BotyB/Automatic-Plant-Watering-System/README.md

# Automatic Plant Watering System

This project is an automatic watering system designed to care for up to four plants independently.

Each plant has its own capacitive soil-moisture sensor and dedicated water pump. Instead of watering every plant on a fixed schedule, the system checks the condition of each pot and waters only the plant whose soil has become too dry.

The system is controlled by an ESP32 microcontroller and uses a four-channel relay module to operate the pumps. Two water-level protection systems monitor the reservoir and prevent the pumps from running when there is not enough water available.

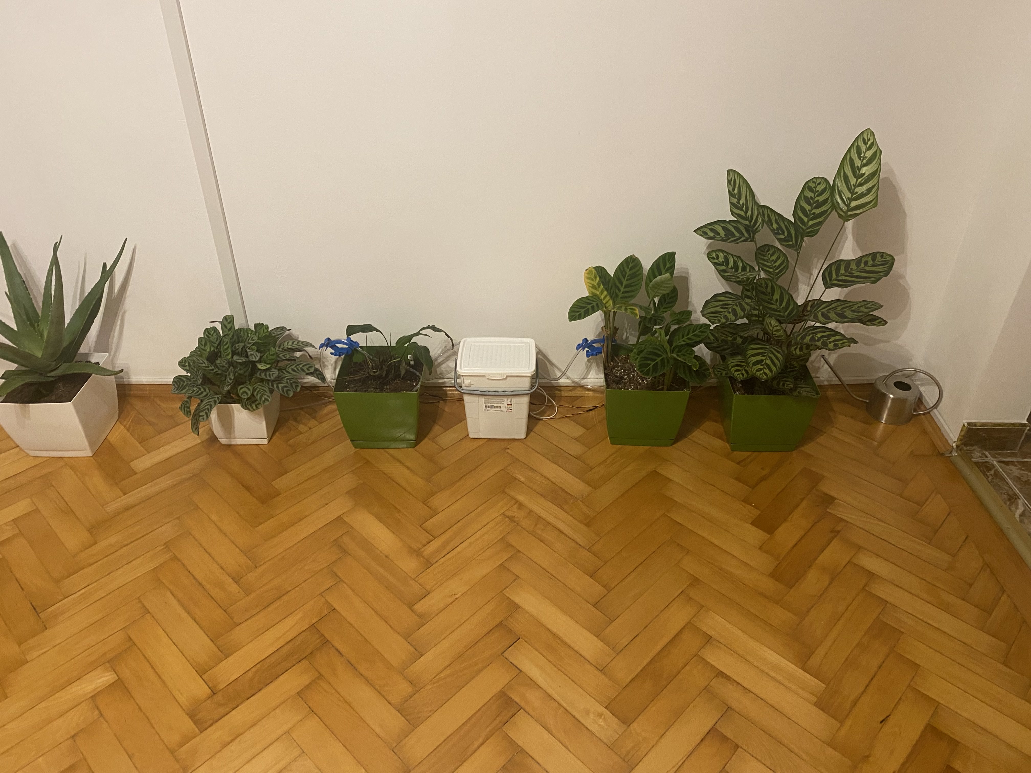
[picture p1: IMG_1337.jpg]


*First Water Bucket that was later replaced with a shorter one*

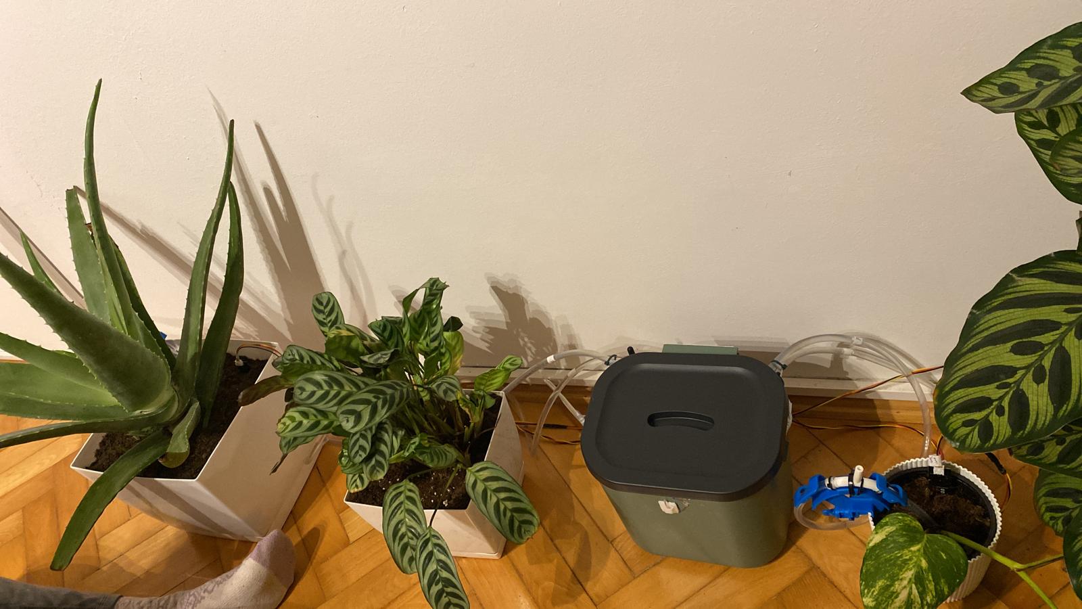
[picture p2: IMG_1446.jpg]


*Final Water Bucket that has a shorter and more compact design*

The main goal was to create a practical system that reduces manual plant care while avoiding both underwatering and unnecessary repeated watering.

## Main Features

* Monitors the soil moisture of four plants separately
* Uses one dedicated water pump for each plant
* Automatically waters only the plants that are too dry
* Monitors the water reservoir level
* Prevents the pumps from running dry
* Can be monitored and controlled through Blynk
* Allows moisture thresholds to be adjusted for different plants
* Uses ventilation lines to prevent unwanted water siphoning after a pump stops
* Uses one pump at a time to reduce peak current
* Includes both software and hardware water-level protection
* Provides visual warning patterns through a front status LED

The system was built as a practical home automation project and can be expanded later with additional sensors, notifications, data logging, or more watering zones.

## 1. Project Idea

The original idea was to build one controller capable of caring for four separate plants.

Each plant would have:

* One soil-moisture sensor
* One dedicated water pump
* One separate water hose
* Its own moisture threshold
* Its own watering interval

This allows plants with different water requirements to be monitored independently instead of treating all four pots as one watering zone.

## 2. Initial Planning

The project began with a paper sketch showing the complete electrical layout before any permanent wiring was made.

The design used one main 5V power source divided into two functional branches.

Original Paper Wiring Sketch


### Logic Branch

The logic branch supplies the low-current electronics:

* ESP32 microcontroller
* Four capacitive soil-moisture sensors
* Four-channel relay control circuit
* Front status LED
* Water-level status input

The four soil sensors are powered from the ESP32's 3.3V output. Their analog signal wires are connected to GPIO pins:

* Sensor 1: GPIO 32
* Sensor 2: GPIO 33
* Sensor 3: GPIO 34
* Sensor 4: GPIO 35

These pins belong to ADC1, which means they can still be used while the ESP32 Wi-Fi connection is active.

The four relay-control inputs are connected to:

* Relay 1: GPIO 16
* Relay 2: GPIO 17
* Relay 3: GPIO 18
* Relay 4: GPIO 19

The warning LED is connected to GPIO 25 through a current-limiting resistor of approximately 220–330 ohms.

### Pump-Power Branch

The second branch supplies the higher-current side of the system:

* Four 5V water pumps
* Relay common terminals
* Hardware water-level cutoff
* Main pump-power path

Separating the logical control section from the higher-current pump branch made the system easier to understand and reduced the chance of pump current affecting the ESP32.

Both branches still share the same 5V supply and common ground. They are functionally separated, not electrically isolated.

## 3. Component Selection

The first stage involved choosing the sensors, pumps, relay module and operating voltage.

Capacitive soil-moisture sensors were selected instead of exposed-metal resistive probes. Capacitive sensors are generally more suitable for long-term installation because the sensing surface does not rely on two exposed metal electrodes that gradually corrode in wet soil.

A four-channel relay module was selected because it allows the ESP32 to switch each pump independently while keeping pump current away from the ESP32 GPIO pins.

Pumps, Sensors and Hoses


*Four capacitive soil sensors, four 5V water pumps and watering hoses.*

Four-Channel Relay


*Four channel relay*

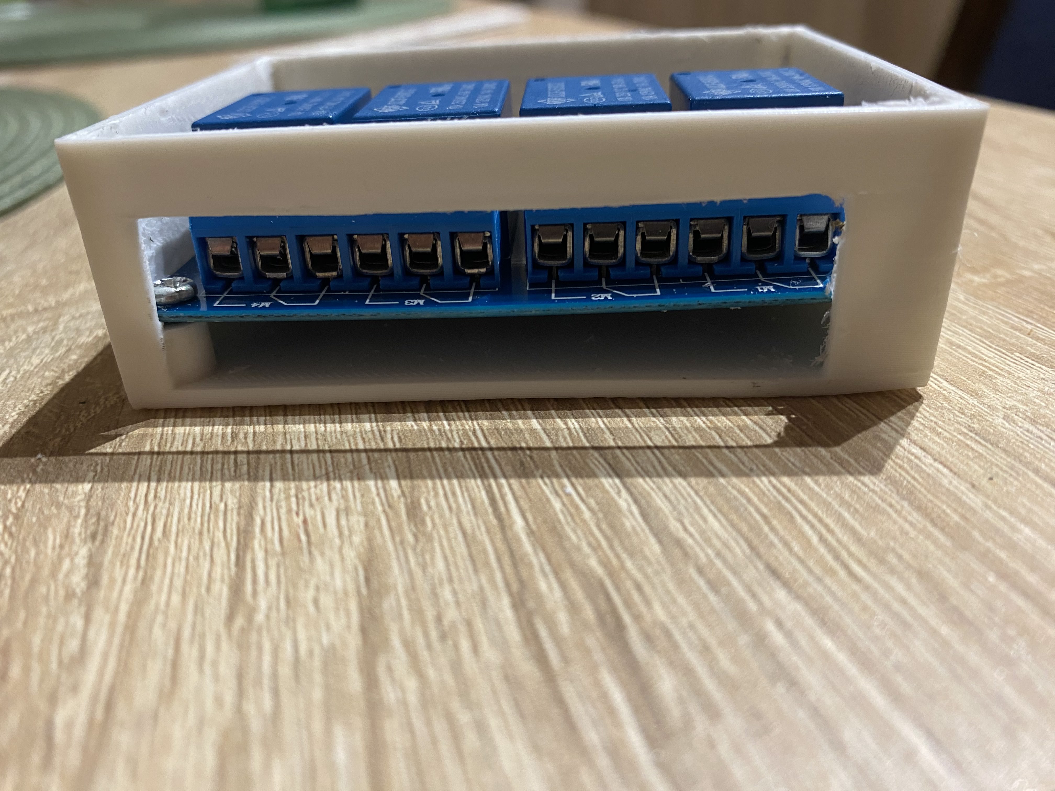
[picture p6: IMG_1287.jpg]
Four-Channel Relay With Case


*I made a custom 3D printed case for the four-channel relay module used to control the pumps independently.*

ESP32-U


*ESP32 38-pin model U with external U.fl antenna*

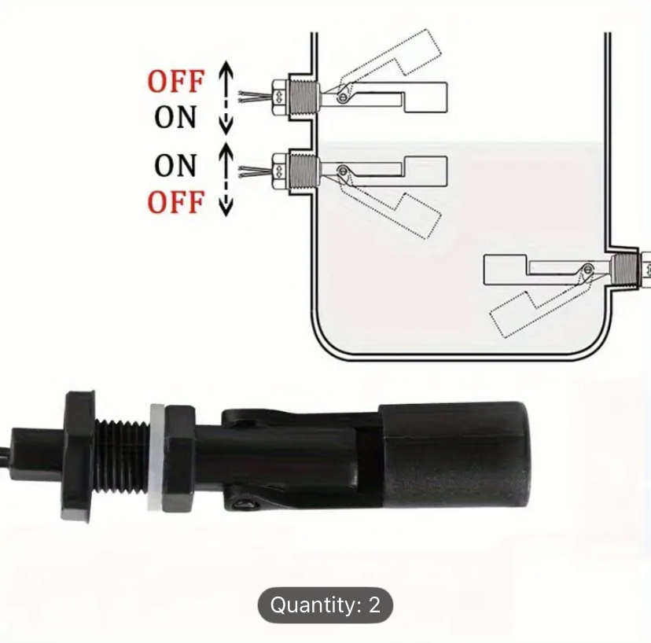
[picture p8: IMG_1284.jpg]


*Schematic of how the floating sensor works*

**NOTE: The sensor can be installed both ways with ballast hanging down or raising with water level**

Reservoir Testing

*The water level sensor that will sit inside the water bucket, its a simple switch that can be used both with the ballast lowering down or rising as water level raises*



*Here i am testing if the sensor works and to check how to install it*

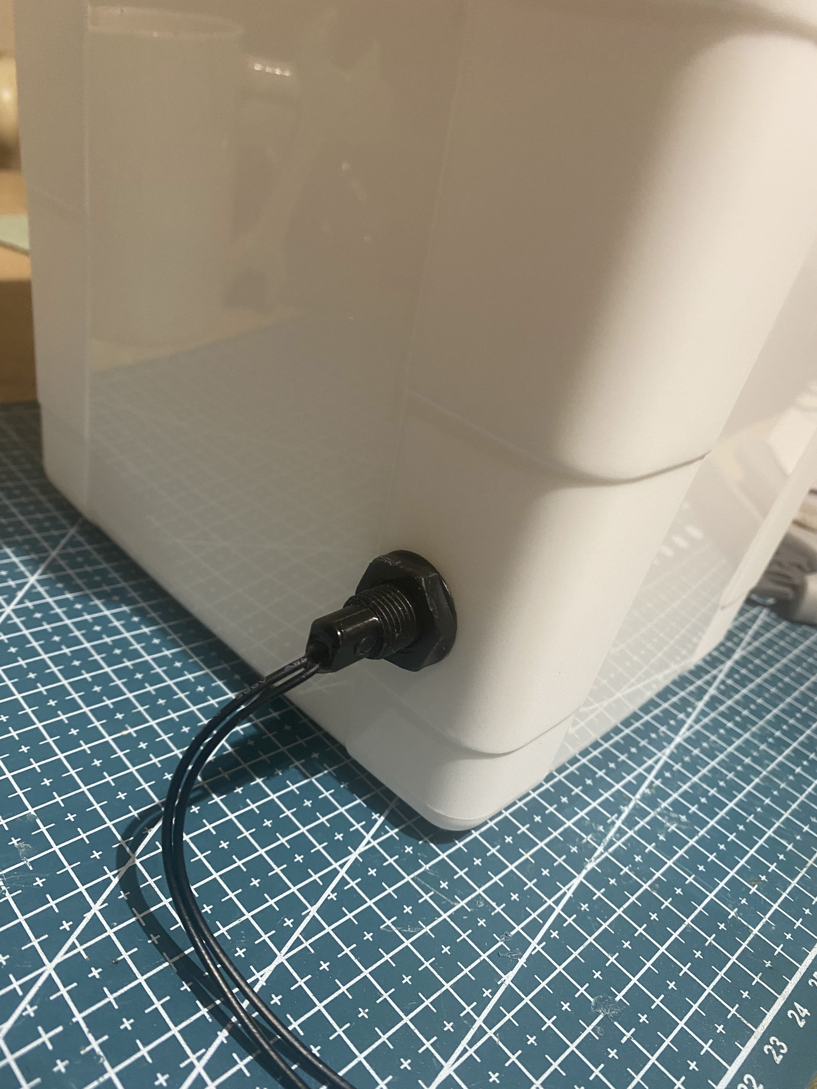
[picture p11: IMG_1316.jpg]
Modified Reservoir


*I have installed the sensor at the lowest point of the first water bucket model leaving some space from the bottom so it will not get stuck*

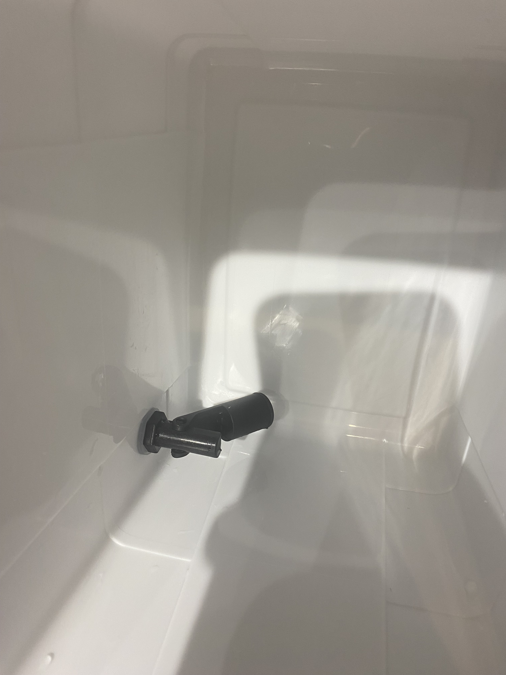
[picture p12: IMG_1317.JPG]
Reservoir Inside POV


*The interior of the bucket with one sensor installed as close to the bottom as possible*

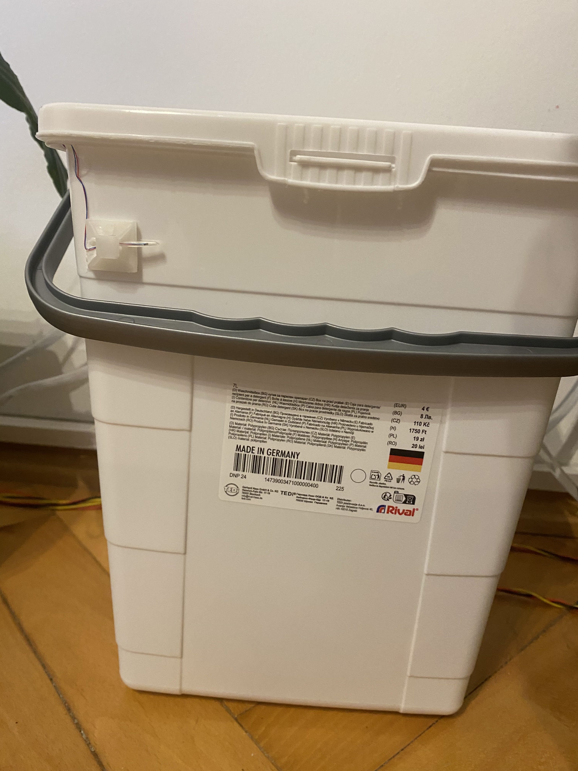
[picture p13: IMG_1350.jpg]
Original Reservoir


**The original taller water reservoir considered during the first build.**

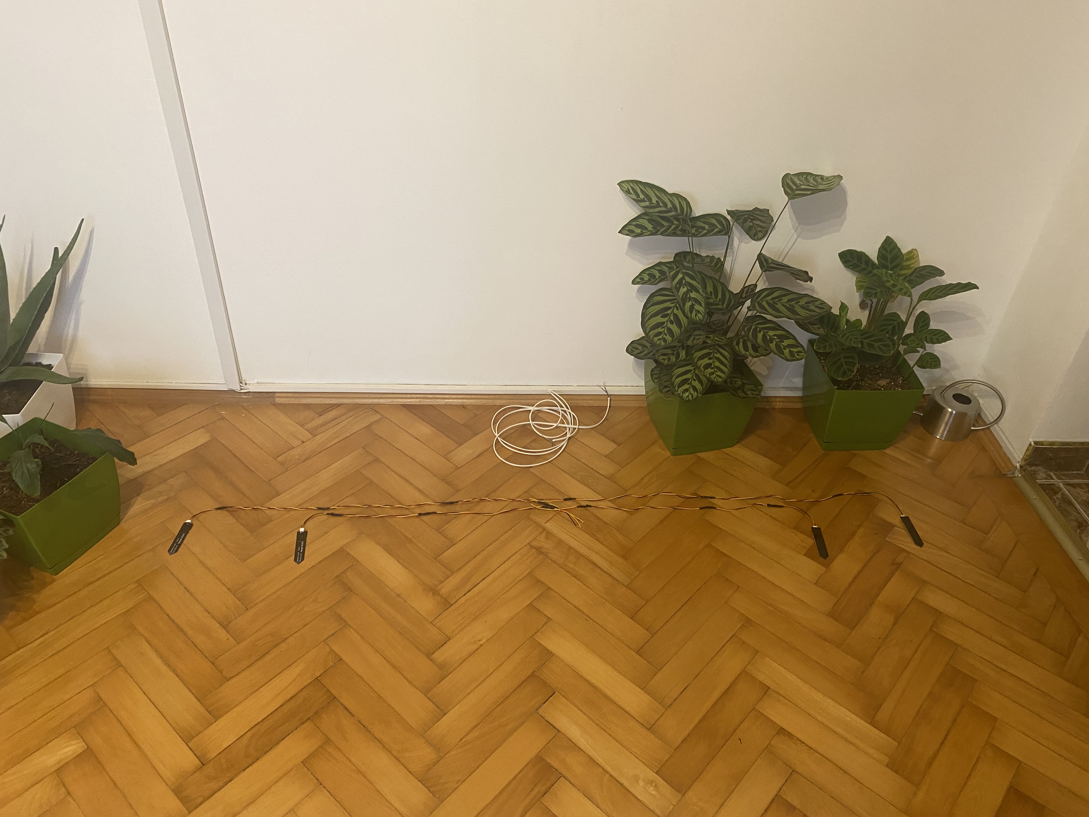
[picture p14: IMG_1331.JPG]
Measuring Sensors Reach

*Measuring how far should the sensors reach all four flower pots*

Reservoir With Sensor And Pumps Installed

*Float sensor and water pumps all installed at the bottom of the bucket, ready to be tested*

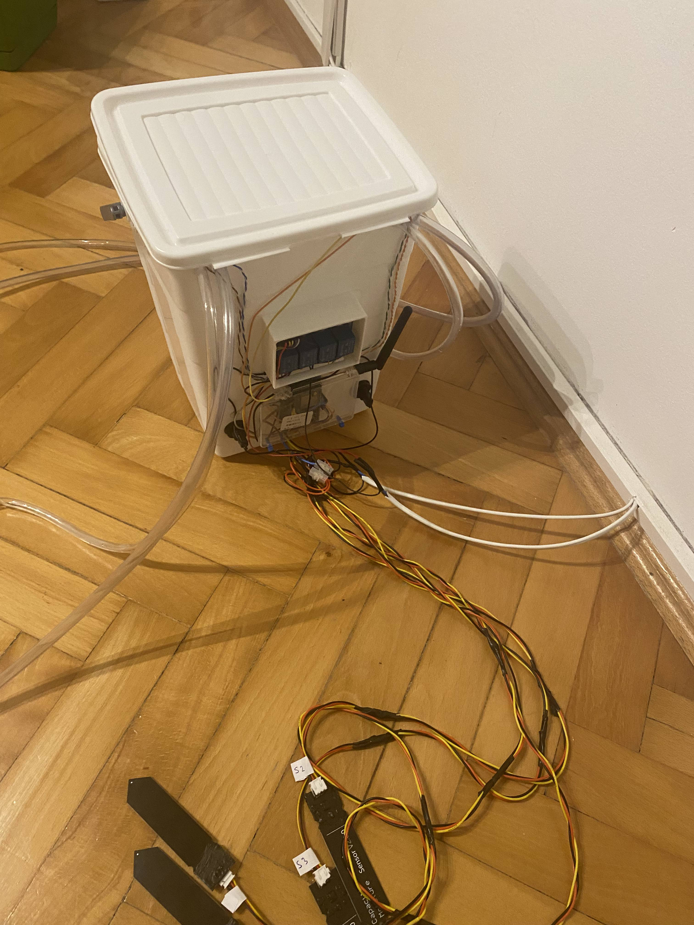
[picture p16: IMG_1335.jpg]
Original Reservoir Mounted Components

*All component are wired and glued to the bucket to be tested with a 5v wall charger rated 3 Amps* 

Both 12V and 5V pumps were considered. The final system uses 5V pumps, allowing the ESP32, relay module and pumps to operate from one suitably rated 5V wall power supply.

A power supply rated for approximately 3A was selected to provide enough current for the controller and pumps. Because the final components all operate from compatible voltages, additional buck converters were not required.

Only one pump is operated at a time. This reduces the peak load on the power supply and prevents several pumps from starting simultaneously.

## 4. Controller and Wireless Connection

The ESP32 provides:

* Built-in Wi-Fi
* Enough GPIO pins for four sensors and four relays
* Multiple ADC1 analog inputs
* Blynk compatibility
* Timers and automatic watering logic
* Remote monitoring and manual control

ESP32-U Controller

*The ESP32-U was fitted inside this plastic container in the case of water getting near it with only the bottom being exposed for code re-flashing* 

An ESP32-U development board was selected as the main controller.

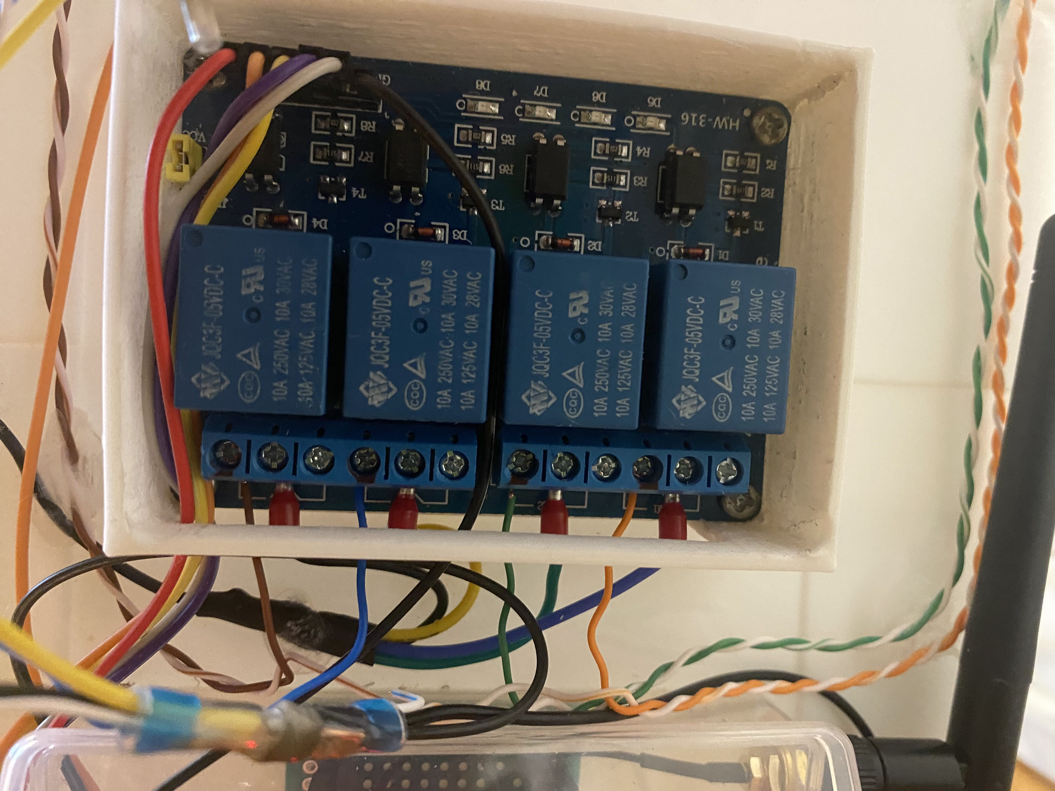
[picture p18: IMG_1340.jpg]
Original Reservoir Mounted Components Back

*The 4-channel relay on the back of the bucket*

**NOTE: it is marked as 250/125/30/28 Volt AC but it works perfectly with a 5v 3A wall charger**

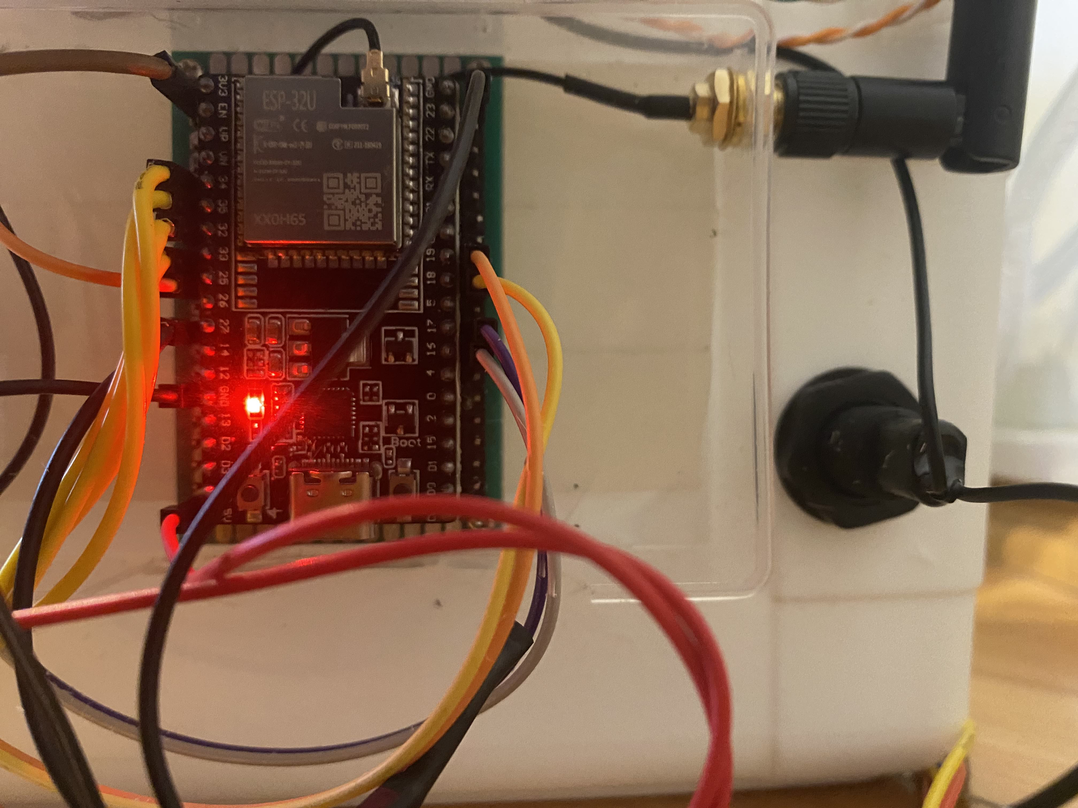
[picture p19: IMG_1341.jpg]
Original Reservoir Mounted Components Back1

*ESP32 powered up and ready to be tested*

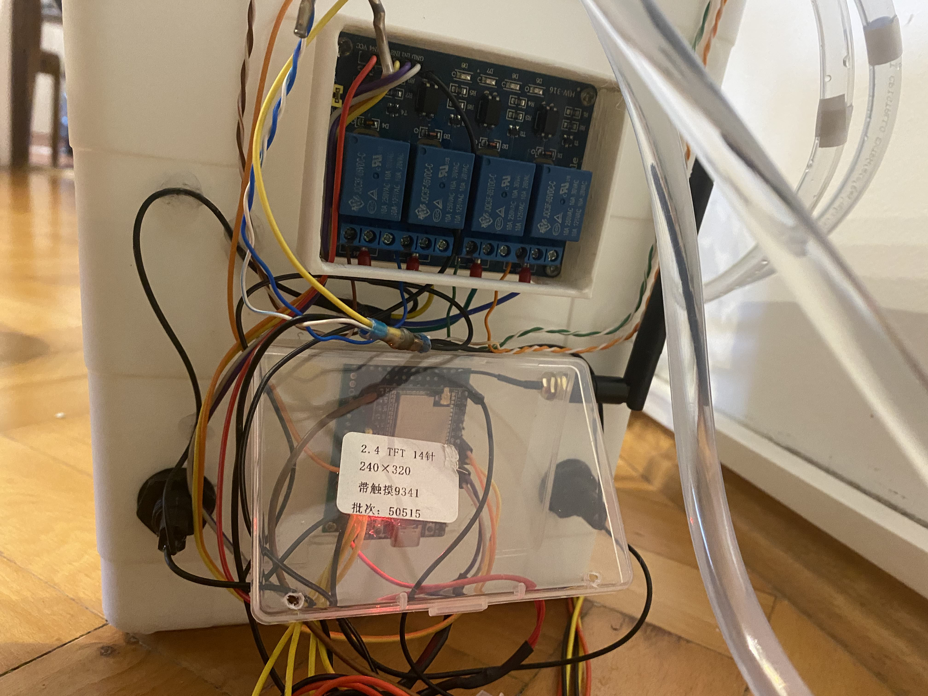
[picture p20: IMG_1342.jpg]
Original Reservoir Mounted Components Back2

*Checking if pump is arming when ESP32 is triggered*

**NOTE: Here you can also see that the system uses dual water level sensors, one is for actual level and the second one is for the main fail-safe for the pumps to shut off when there is no water**

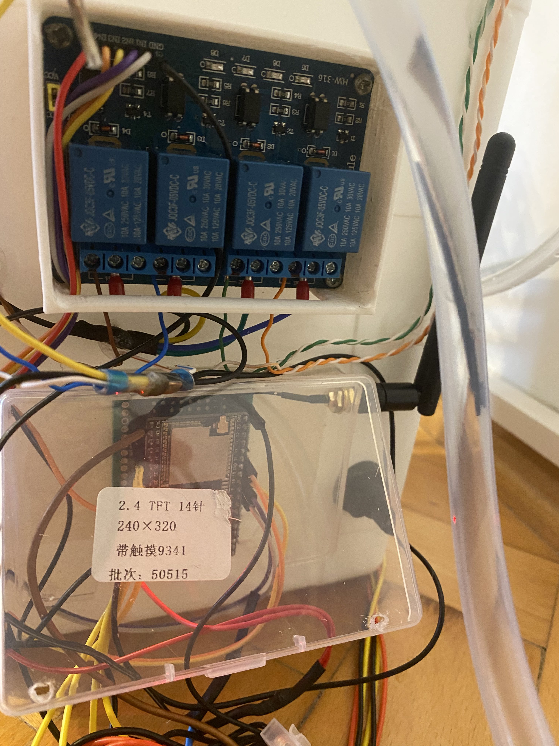
[picture p21: IMG_1343.jpg]
Original Reservoir Mounted Components Back3

*Added zip-tie holes so i can close the lid of the ESP32*

**NOTE: final design uses 2x water level sensors so one shots off the pumps from starting dry and the other to show the water level in the app**

The ESP32-U version was chosen because it supports an external antenna through a U.FL connector.

Although a regular ESP32 module with a PCB antenna may be sufficient in many indoor installations, the external antenna provides more freedom when mounting the controller inside an enclosure or near objects that can weaken the Wi-Fi signal.

The antenna can be positioned outside or away from the main electronics enclosure, improving the reliability of the connection to the router.

Some ESP32 boards that include both a PCB antenna and a U.FL connector require a small hardware antenna-selection change. This should be checked for the exact board model before connecting an external antenna.

## 5. Soil Sensor Protection

Only the lower sensing section of a capacitive soil sensor is intended to remain inside the soil.

The upper electronic section contains exposed components and solder joints that can be damaged by water, condensation or wet soil. This section was protected using liquid electrical tape or silicone sealant.

At first i was considering to use a water sensor that measures the water level but after some research and testing it proved ineffective for this project

Water Sensor mk1
First water sensor i considered to use but its main weakness is that the traces corrode quite fast so it got scrapped

After swapping, i tested the Capacitive Soil Sensor v2.0 since i have read that the older v1.3 had some issues with the reliability of the sensor.

Testing Soil Sensor Voltage

*Here the Soil Sensor is tested in water if the voltage changes with the moisture level*

Testing Soil Sensor Voltage Wet

*The voltage has dropped to 1.4v as expected*

Testing Soil Sensor Voltage Dry

*Then when in dry air the voltage raises to 2.7v. This is by design since the capacitance changes*

**NOTE: This type of sensor measures moisture and by design in dry air it will output around 3v and in wet soil it will reach around 1v**

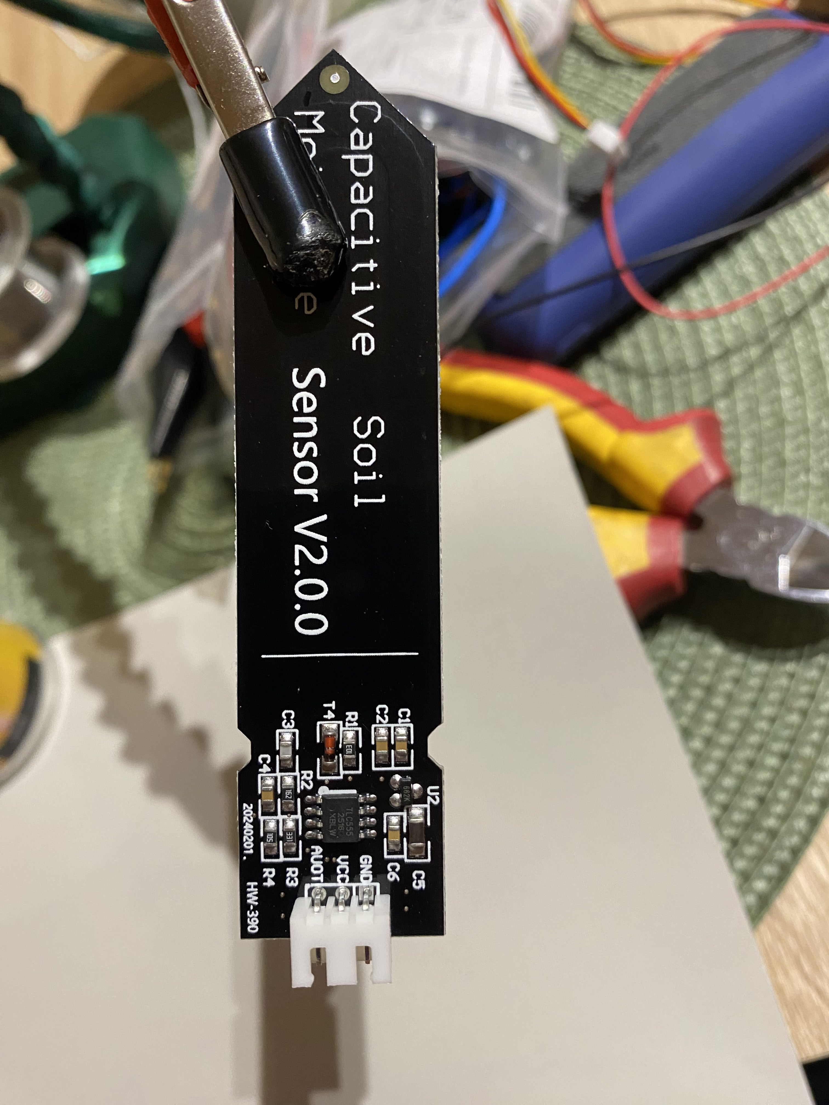
[picture p25: IMG_1112.jpg]

*This was the chosen soil sensor but this design has a major flaw, its electronics are exposed to water damage*

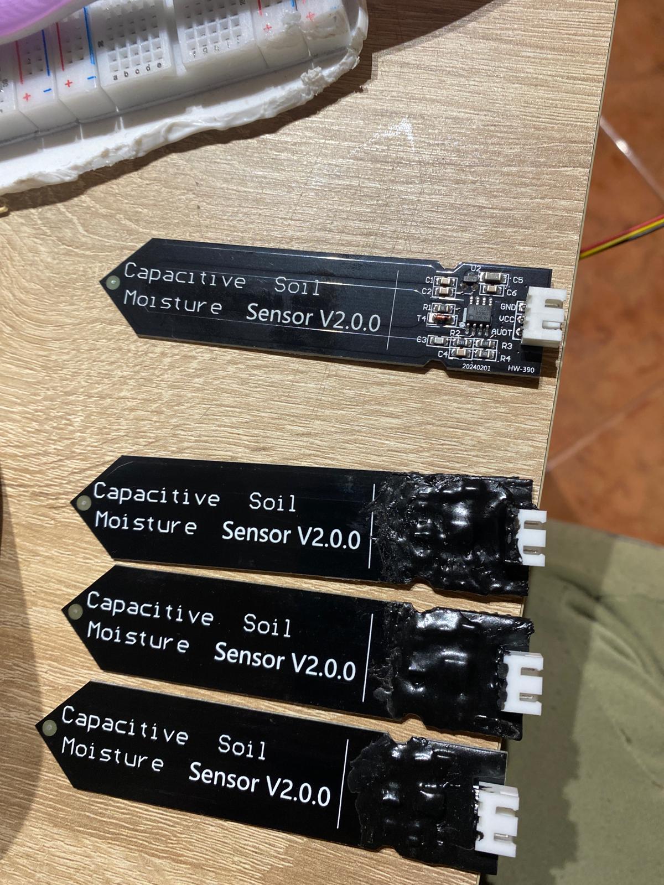
[picture p26: IMG_1443.jpg]

*The sensors have been coated with liquid tape to protect from damage* 

The protective coating was applied around:

* The electronic components
* Solder joints
* Cable connection
* Upper edge of the circuit board

The active sensing area was left uncovered so the sensor could continue measuring changes in soil moisture correctly.

Care was also taken not to bury the electronic section below the soil line.

## 6. 3D-Printed Flow Breakers and Vent Lines

To fully stop unwanted siphoning, custom 3D-printed flow breakers were added near the ends of the watering hoses.

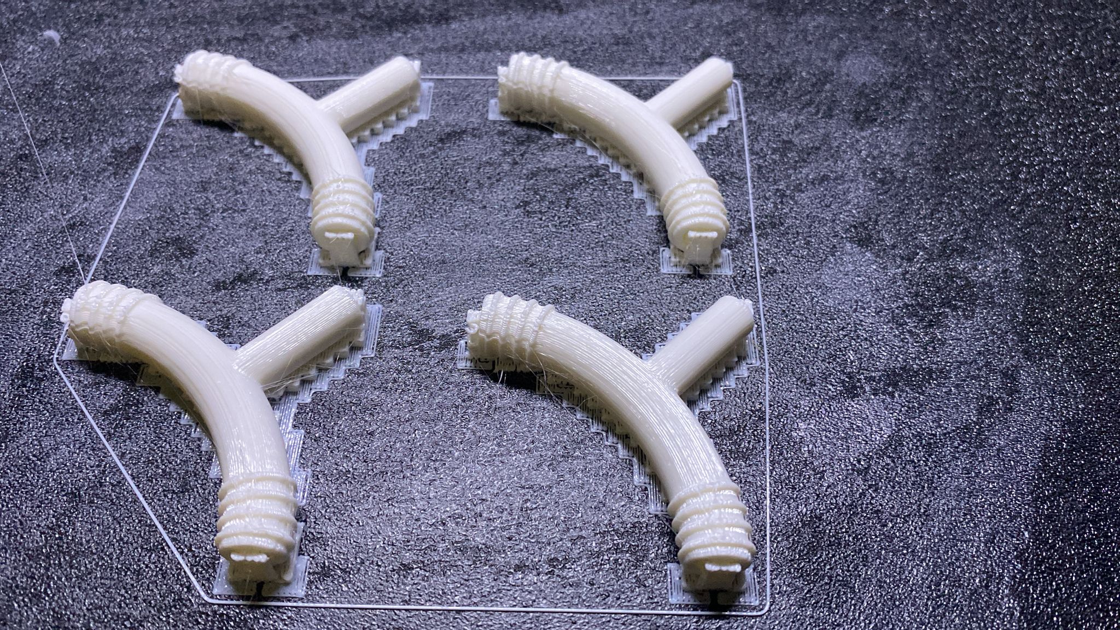
[picture p27: IMG_1431.jpg]
3D Printed Flow Breaker

*I have made this design so it will fit the chosen hoses and to break the syphon effect since it lets water get inside with the top vent*

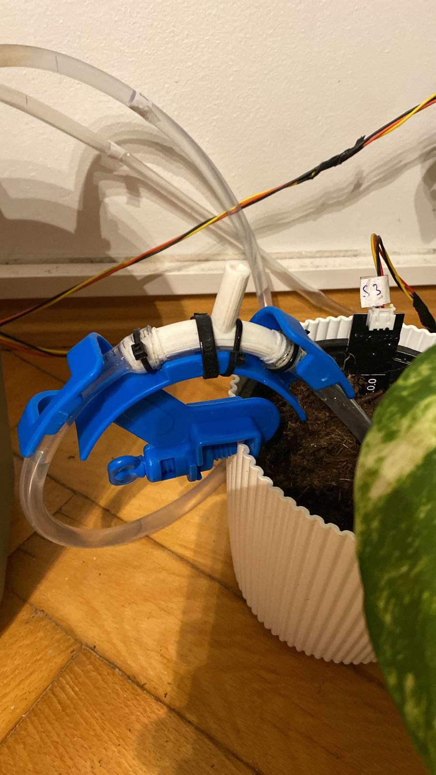
[picture p28: IMG_1444.jpg]
3D Printed Flow Breaker Plant

*Installed on the plant pot holder and with the syphon breaker added*

Each outlet includes a curved vent section that allows air to enter the hose after the pump stops. Introducing air breaks the continuous water column inside the hose and interrupts the siphon effect.

Without the vent, a hose filled completely with water can continue drawing water from the reservoir even though the pump is no longer powered.

The final arrangement provides two forms of siphon protection:

* A shorter reservoir with less height above the plants
* Vented 3D-printed hose outlets that break the water column

This ensures that each plant receives approximately the intended pump dose rather than continuing to receive water through gravity flow.

## 7. Water Reservoir and Siphon Problem

**NOTE: Please do read the whole project since in early testing the system worked but i had an unforeseen problem that the pump stopped but the water kept syphoning and it filled the pot till it got out**

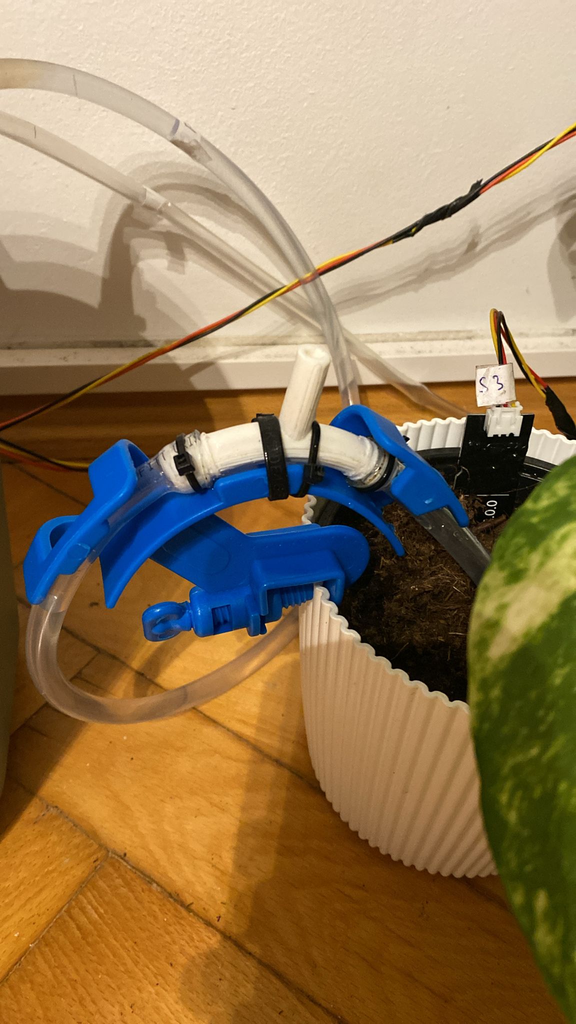
[picture p29: IMG_1432.jpg]
Front Status LED


*3D printed syphon breakers were added so air can enter and break the syphon effect*

*After more testing i have found that the vent was not tall enough*

*NOTE: The vent was tilted forward towards the flower pot so any leaking water will spill back into the pot not out*

**NOTE #2: If you do not have a 3D printer or find an adequate syphon breaker you can just poke a hole with a thicker needle in the top part of the hose to get the exact same effect, just check if the water will flow back inside the pot or out**

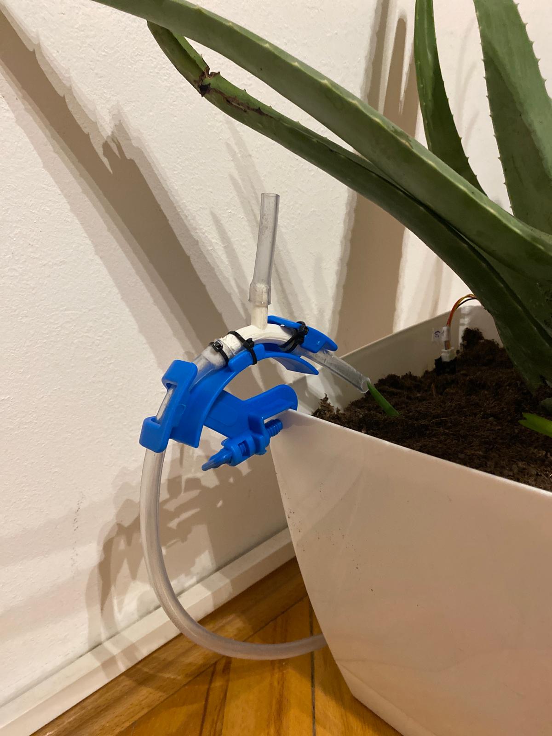
[picture p30: IMG_1447.jpg]


*Added a piece of hose to make the vent taller so this way it could not splash water out and work flawlessly*

The first reservoir was relatively tall. During testing, its water level could remain higher than the ends of the watering hoses.

This created a siphoning problem. After a pump stopped, water could continue moving through the hose because of the height difference between the reservoir and the plant pots. In some cases, this allowed more water to leave the reservoir than intended and created a risk of overflowing the pots.

The taller bucket was therefore replaced with a shorter container. Lowering the reservoir reduced the vertical pressure difference and made unwanted gravity-fed water flow less likely.

Completed Front Panel

*The original bucket that got replaced because of the height*

**The bucket design shown above was changed because the water level was higher than the flower pots. After a pump started the flow, the siphon effect could continue even after the pump stopped, allowing the reservoir to drain until its water level matched the height of the hose outlet.**

**For this reason, a siphon breaker was added later in the design, giving the system two independent anti-siphon safeguards instead of relying on only one.**

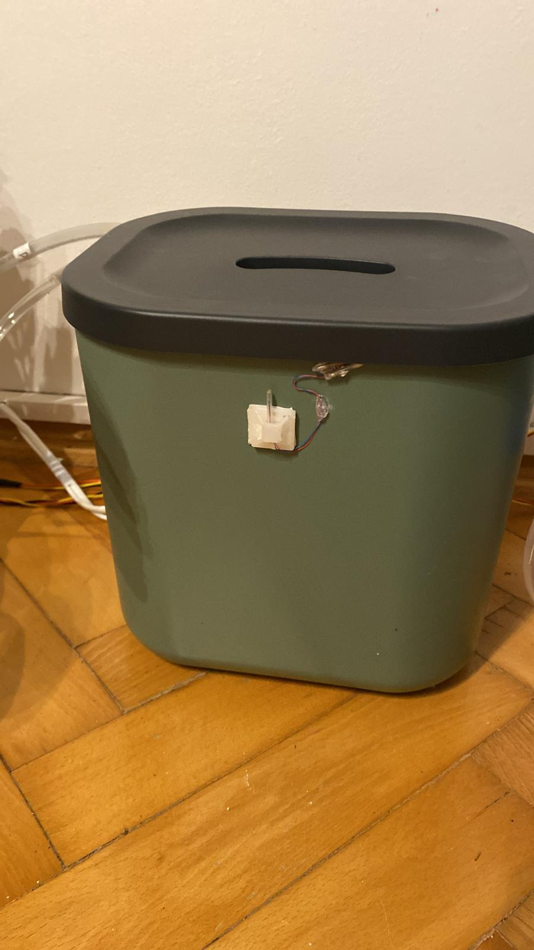
[picture p31: IMG_1445.jpg]


*This is the final design that i have choose for this project and successfully tested*

Changing the bucket alone improved the system, but it did not fully guarantee that every hose would stop flowing immediately.

## 8. Safety and Warning Systems

The system includes both software and hardware protection.

### Scheduled Watering Window

Automatic watering is permitted only between **07:00 and 22:00**.

The end time is exclusive, meaning automatic watering can run from:

* **07:00**
* Until
* **21:59**

At 22:00 and during the night, automatic watering is blocked.

This reduces the chance of a leak, overflow or unexpected pump operation occurring while the system is less likely to be observed.

Manual watering can still be started outside this time window, but the empty-tank protection remains active.

### Minimum Watering Interval

Each plant has an independent minimum interval between automatic watering attempts.

The default interval is *3 hours*

You can see the countdown in the mobile / web app

*NOTE: The below UI was made using Blynk's design tools from the platform / app , check 11. Blynk Web and Mobile Dashboard for more*

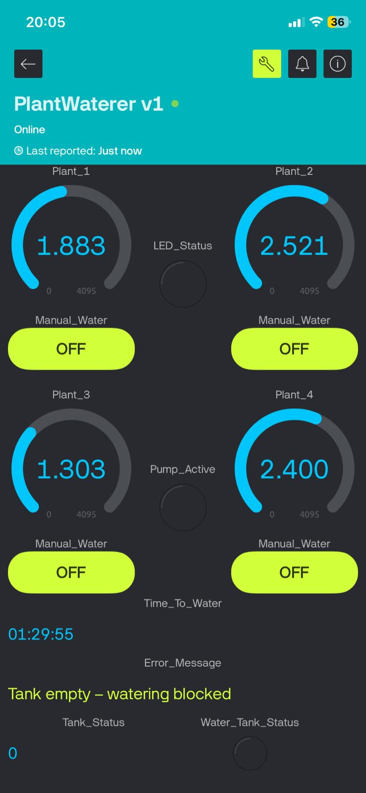
[picture p32: IMG_1450.jpg]


*Time_To_Water shows the time left till the system can automatically water the plants*

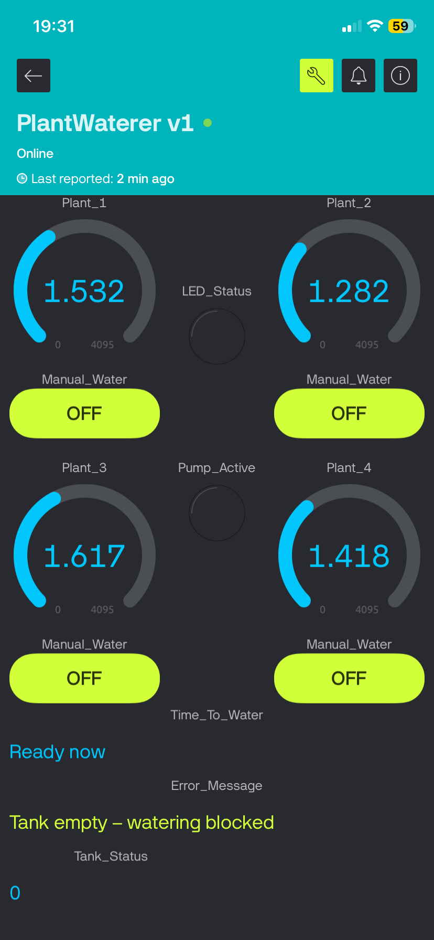
[picture p33: IMG_1441.jpg]


*Time_To_Water is on "Ready Now" so it can water each plant if the soil sensor sends a signal*

### Software Water-Level Protection

One float sensor is connected to the ESP32. The program checks this sensor before starting a pump.

When the tank is empty:

* Automatic watering is blocked
* Manual watering is blocked
* An error is shown in Blynk
* The front warning LED begins flashing
* Any active pump is stopped

### Independent Hardware Cutoff

A second water-level switch is installed directly in the pump-power branch.

This switch physically disconnects power from the pumps when the water level becomes too low. Because this protection does not depend on the ESP32 or software, it can still stop the pumps if:

* The ESP32 freezes
* Wi-Fi disconnects
* Blynk becomes unavailable
* A software error occurs
* The status sensor fails to be processed correctly

The hardware switch acts as the final dry-run protection for the pumps.

### One-Pump-at-a-Time Protection

The program permits only one pump to operate at a time.

This:

* Reduces peak current
* Prevents simultaneous watering
* Makes pump activity easier to track
* Reduces stress on the power supply

### Watering Interval Protection

After automatic watering, the affected zone must wait before it is eligible for another automatic dose.

This gives water time to spread through the soil and reach the moisture sensor. Without this delay, the system could water repeatedly while the sensor still temporarily reports dry soil.

## 9. Overflow Warning: Test Before Leaving the System Unattended

 **[!WARNING]**
 **Always test the complete system under supervision before allowing it to operate unattended.**

Although the system includes several software and hardware safety features, every installation is different. Hose position, pump flow, reservoir height, pot size and soil absorption can all affect how the system behaves.

A small mistake can result in leaking water, an overflowing flower pot or the reservoir draining through an unintended siphon.

Before regular use, test every watering zone individually.

### Leak Test

Inspect the complete water path:

* Reservoir walls and lid
* Pump connections
* Hose connections
* Hose outlets
* 3D-printed flow breakers
* Areas where cables or hoses pass through the enclosure

Run each pump while watching the complete hose path. Check again several minutes after the pump stops, because some leaks may appear slowly.

### Watering-Dose Test

Test each plant separately and confirm that the programmed pump duration delivers a suitable amount of water.

The default pump duration may not be correct for every installation because water flow depends on:

* Pump performance
* Hose length
* Hose diameter
* Vertical height
* Flow restrictions
* Pot size
* Soil type

Begin with a short watering duration and increase it gradually. It is safer to provide too little water during testing than to overflow the pot.

### Siphon-Break Test

After each pump stops, watch the hose outlet and confirm that water flow stops completely.

Verify that:

* Air enters through the curved vent
* The water column inside the hose is broken
* Water does not continue dripping continuously
* The reservoir level does not continue falling
* The pot does not continue filling after the pump switches off

Test the siphon breakers with the reservoir full, because the siphon risk is greatest when the water level is at its highest.

### Empty-Tank Test

Test both water-level protection systems before relying on them.

1. Lower the water level until the software float sensor reports an empty tank.
2. Confirm that automatic and manual watering are blocked.
3. Confirm that the front warning LED begins flashing rapidly.
4. Confirm that Blynk displays an empty-tank warning.
5. Test the independent hardware float switch.
6. Confirm that it physically removes power from the pumps.

Never test a pump dry for an extended period. Only operate it briefly enough to confirm that the protection works.

### Long-Duration Observation Test

Before leaving the system unattended, allow it to operate under supervision for several watering cycles.

Check for:

* Slow leaks
* Loose hoses
* Incorrect sensor readings
* Repeated watering
* Water continuing to flow after pump shutdown
* Overflowing drainage trays
* Wi-Fi reconnection problems
* Incorrect pump-to-plant assignments

The first tests should be performed with the reservoir partially filled. Do not begin testing with a completely full container unless the system is placed somewhere that can safely handle accidental water release.

**[!CAUTION]**
**Do not place the reservoir or hoses above electronics, power strips, furniture or flooring that could be damaged by water.**

## 10. Front Status LED

The LED was placed in front of the bucket to be best visible but can also be placed on the side or back.

Automatic Plant Watering System

*LED fixed to bucket using a zip-tie base*

**Both designs use the same 3MM LED with a 220-330 Ohm Resistor soldered on the anode (+) or the longer leg**

Completed Plant Watering System

*LED fixed to old bucket design using a zip-tie base*

A front-mounted status LED provides basic information without requiring the Blynk application to be opened.

The current warning patterns are:

* Normal operation: LED remains off
* Pump active: two short flashes repeat every second
* Tank empty: LED flashes rapidly and continuously

The empty-tank pattern remains active until the reservoir is refilled and the float sensor returns to the normal position.

The same conditions are also reported through the Blynk dashboard.

## 11. Blynk Web and Mobile Dashboard

The system can be monitored and controlled through Blynk on both desktop and mobile devices.

**Mobile Dashboard**

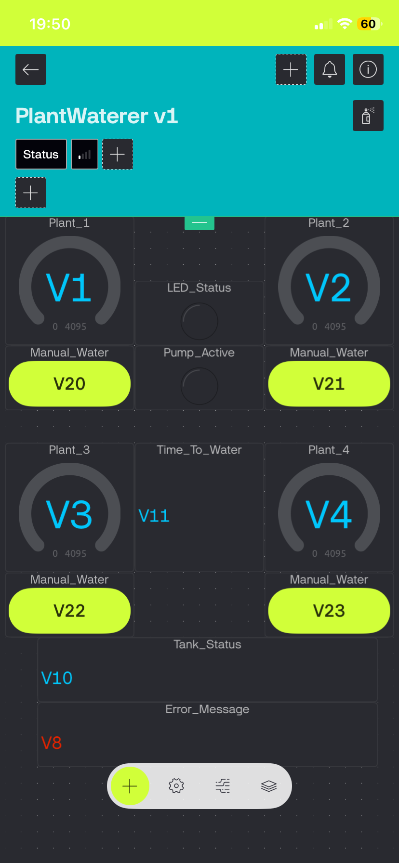
[picture p34: IMG_1426.jpg]


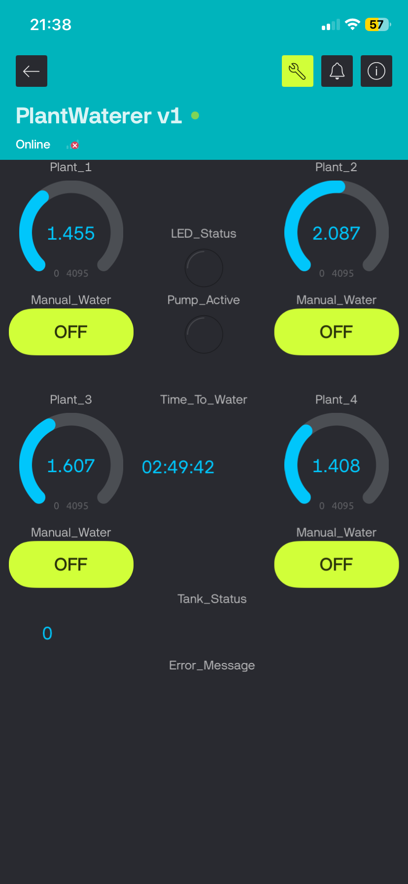
[picture p35: IMG_1428.jpg]


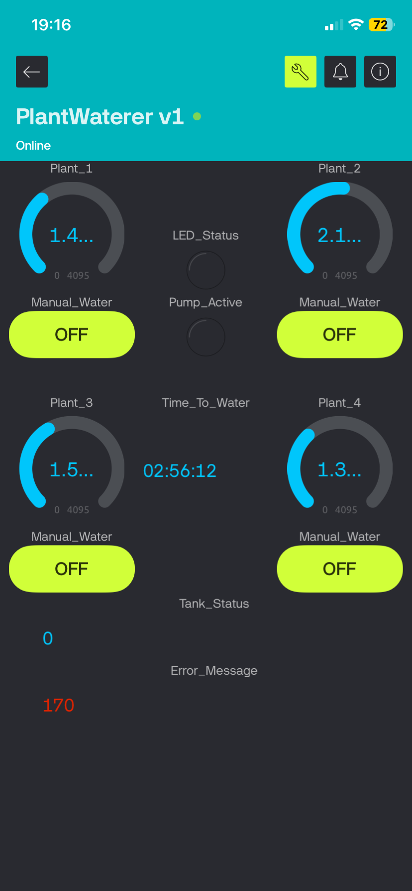
[picture p36: IMG_1429.jpg]


**Web Dashboard**

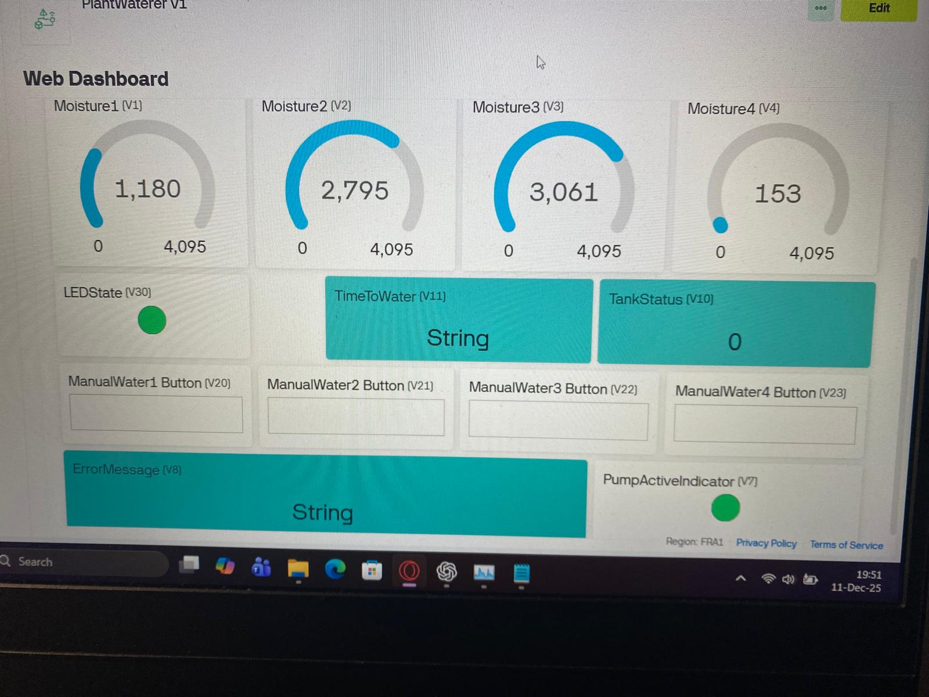
[picture p37: IMG_1451.jpg]
Blynk Web Dashboard


### Dashboard Features

* Displays the moisture level of all four plants from 0% to 100%
* Allows individual manual watering
* Shows whether a pump is currently active
* Displays the remaining safety interval before automatic watering is allowed again
* Shows water-tank status
* Reports errors and blocked watering conditions
* Provides status indicators for normal operation, watering and an empty reservoir

Manual watering ignores the scheduled watering hours and normal automatic watering interval. However, it does not bypass the empty-tank protection.

### Moisture Calibration

The ESP32 internally reads each sensor using a raw ADC range from 0 to 4095. These readings are converted into a simpler percentage for the dashboard.

Default calibration values are approximately:

* 1200: very wet
* 2000: moderately wet
* 2600 or more: becoming dry
* 3200: very dry

With the default conversion:

* 100% means very wet
* Approximately 50% means medium moisture
* 0% means very dry

Every capacitive sensor can produce slightly different values, so wet and dry calibration should be performed for the actual sensors and soil being used.

### Status Indicators

* Normal: status LED remains off
* Watering: two short flashes repeat every second
* Tank empty: the LED flashes rapidly and continuously
* Pump active: the Blynk pump indicator turns on while one of the pumps is running
* Error message: reports an empty tank, another active pump, watering outside the permitted hours, or missing clock synchronization

## 12. Software Setup

1. Download or clone the GitHub repository.
2. Copy `secrets.example.h`.
3. Rename the copy to `secrets.h`.
4. Open `secrets.h` and replace the placeholder values with your own credentials:

```cpp
#define BLYNK_TEMPLATE_ID   "YOUR_BLYNK_TEMPLATE_ID"
#define BLYNK_TEMPLATE_NAME "YOUR_BLYNK_TEMPLATE_NAME"
#define BLYNK_AUTH_TOKEN    "YOUR_BLYNK_AUTH_TOKEN"

#define WIFI_SSID "YOUR_WIFI_NETWORK_NAME"
#define WIFI_PASS "YOUR_WIFI_PASSWORD"
```

5. Keep `secrets.h` private. It is excluded from Git through `.gitignore`.
6. Open `PlantWaterer.ino` in Arduino IDE.
7. Install the ESP32 board package and Blynk library if they are not already installed.
8. Select the correct ESP32 board and COM port.
9. Upload the sketch to the ESP32.
10. Configure each Blynk moisture datastream with a minimum value of 0 and a maximum value of 100.

## 13. Calibration and Use

The default sensor calibration in the code is:

```cpp
constexpr int RAW_WET = 1200;
constexpr int RAW_DRY = 3200;
```

These values are starting points only.

For better accuracy:

1. Record the sensor reading in very wet soil.
2. Record the sensor reading in dry soil.
3. Replace `RAW_WET` and `RAW_DRY` with the measured values.
4. Repeat testing for all four sensors.
5. Adjust each plant's target moisture percentage if necessary.
6. Adjust the pump run time for each zone according to pot size, hose flow and plant needs.

The system should be observed during initial testing to confirm that:

* Each relay controls the correct pump
* Each sensor is assigned to the correct plant
* The tank sensors react correctly
* The pumps stop when the reservoir is empty
* The vented hose outlets break siphoning
* The Blynk readings match the physical system
* The watering dose is suitable for each pot
