BotyB/Automatic-Plant-Watering-System/IMG_1338.jpg

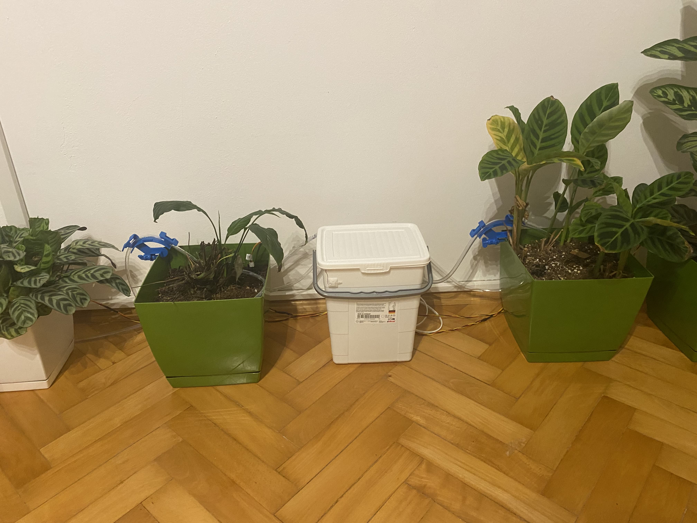
IMG_1338.jpg
