BotyB/Automatic-Plant-Watering-System/IMG_1430.jpg

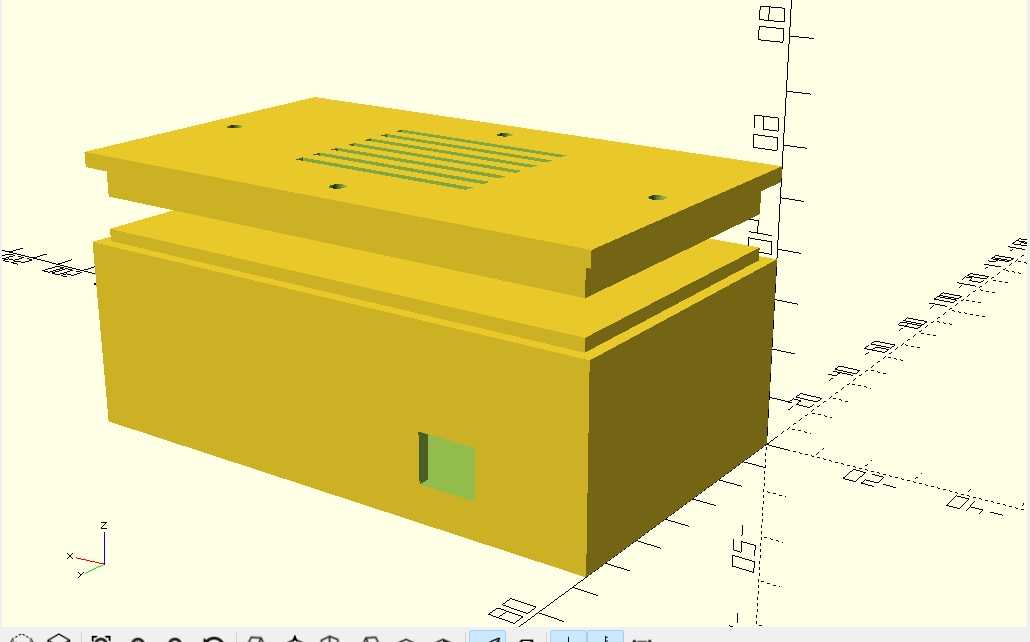
IMG_1430.jpg
