BotyB/Automatic-Plant-Watering-System/IMG_1448.jpg

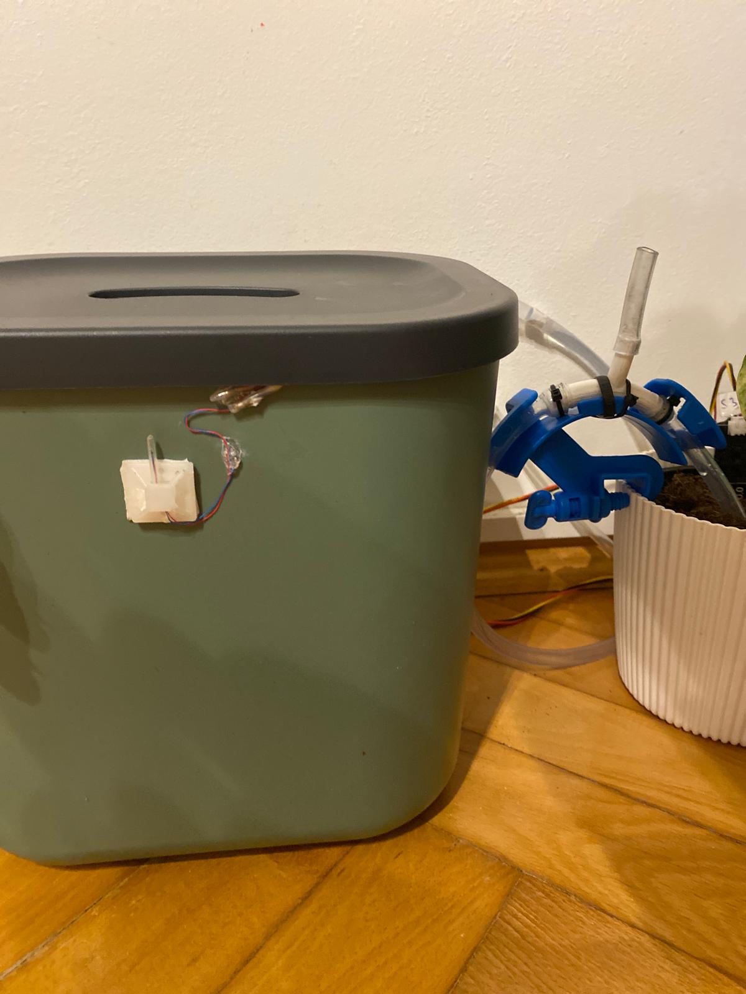
IMG_1448.jpg
