BotyB/Automatic-Plant-Watering-System/secrets.example.h

#pragma once

/*
  Copy this file and rename the copy to:

      secrets.h

  Then replace the placeholder values below with your own credentials.

  Never upload secrets.h to a public repository.
*/

#define BLYNK_TEMPLATE_ID   "YOUR_BLYNK_TEMPLATE_ID"
#define BLYNK_TEMPLATE_NAME "YOUR_BLYNK_TEMPLATE_NAME"
#define BLYNK_AUTH_TOKEN    "YOUR_BLYNK_AUTH_TOKEN"

#define WIFI_SSID "YOUR_WIFI_NETWORK_NAME"
#define WIFI_PASS "YOUR_WIFI_PASSWORD"
