BotyB/Automatic-Plant-Watering-System/(commit log)

2026-07-17 Enhance README with images and detailed descriptions
    Added images and descriptions for components and design changes, including the final water bucket design and sensor protection measures. Updated sections on controller and siphon problems.No.5
2026-07-29 Enhance README with sensor details and images
    Updated README with additional notes and images regarding sensor installations and testing.
