BotyB/Automatic-Plant-Watering-System/IMG_1347.jpg

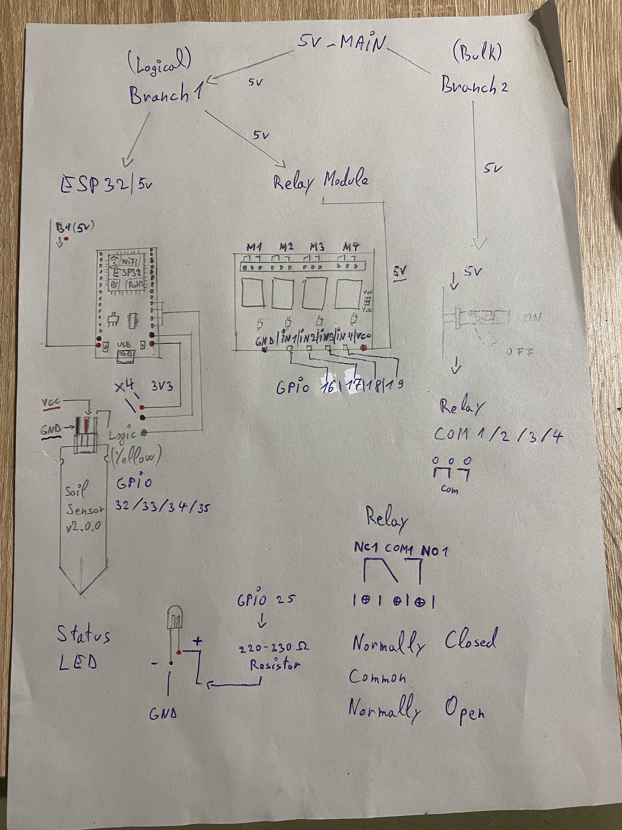
[picture p3: IMG_1347.jpg]
IMG_1347.jpg
