BotyB/Automatic-Plant-Watering-System/IMG_1351.jpg

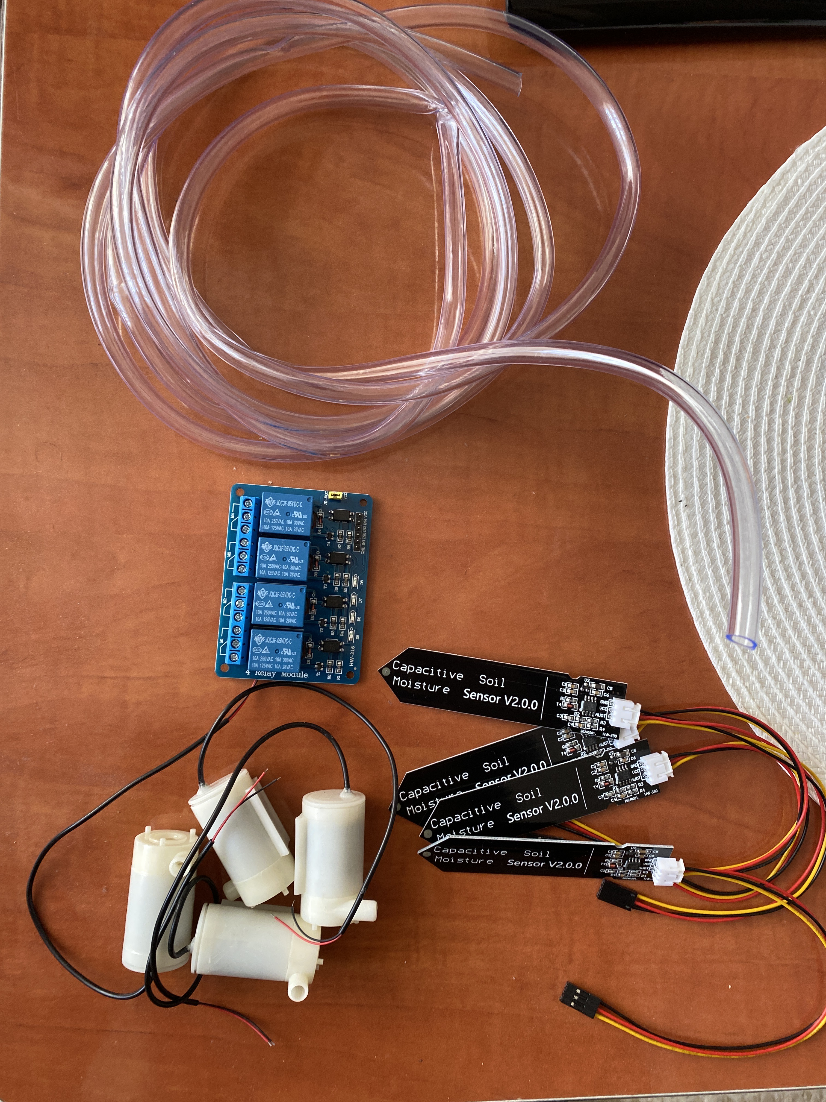
[picture p4: IMG_1351.jpg]
IMG_1351.jpg
