BotyB/Automatic-Plant-Watering-System/IMG_1353.jpg

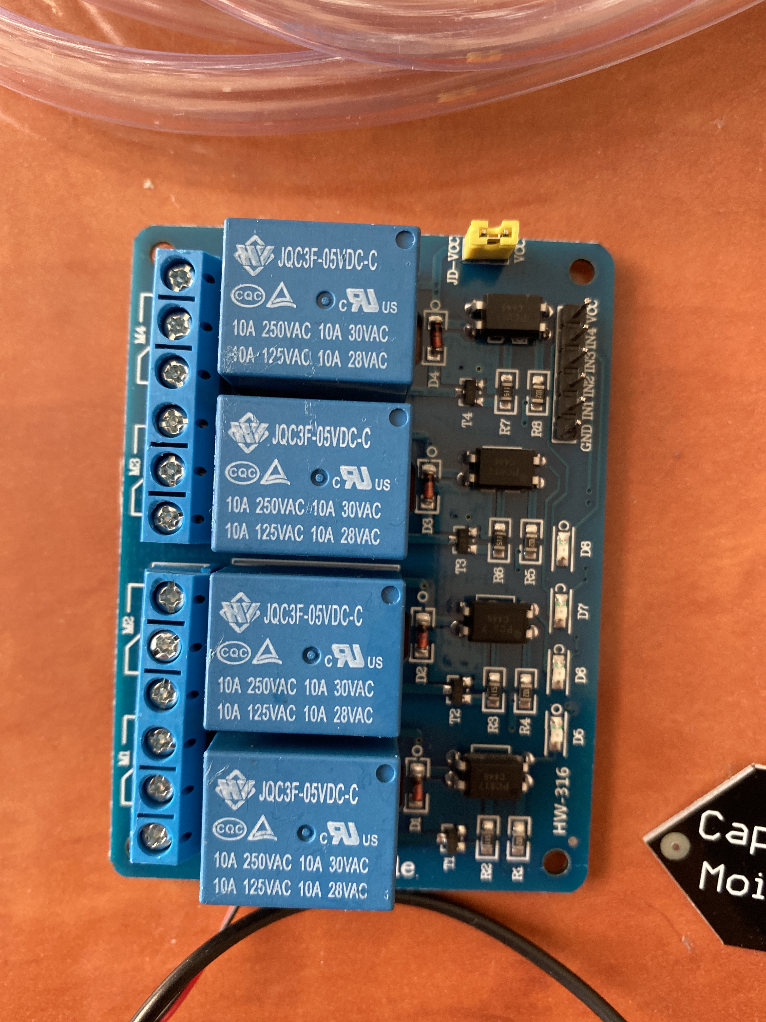
[picture p5: IMG_1353.jpg]
IMG_1353.jpg
