BotyB/Automatic-Plant-Watering-System/IMG_1111.jpg

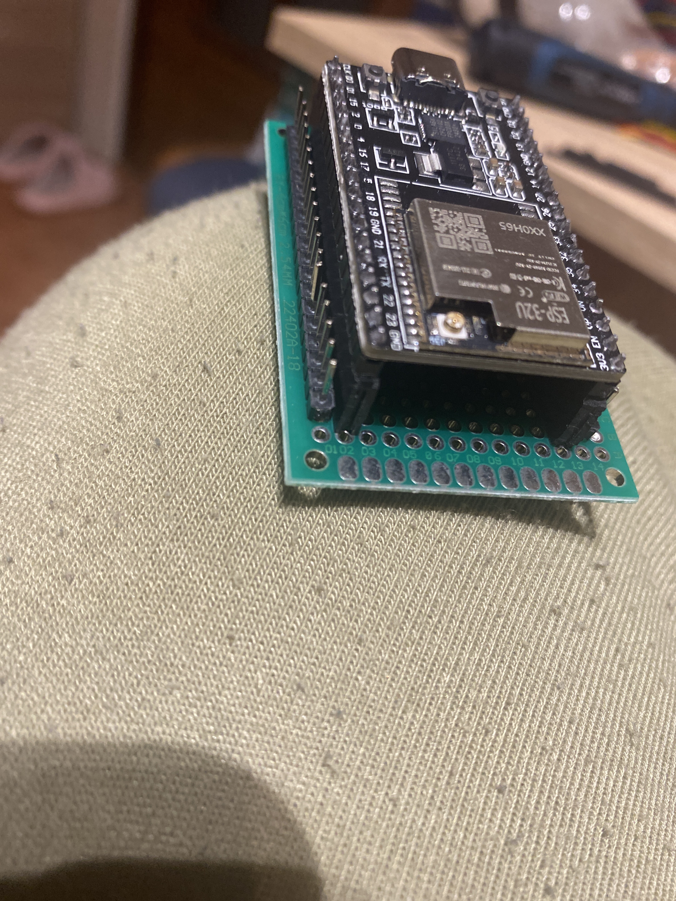
[picture p7: IMG_1111.jpg]
IMG_1111.jpg
