BotyB/Automatic-Plant-Watering-System/IMG_1314.jpg

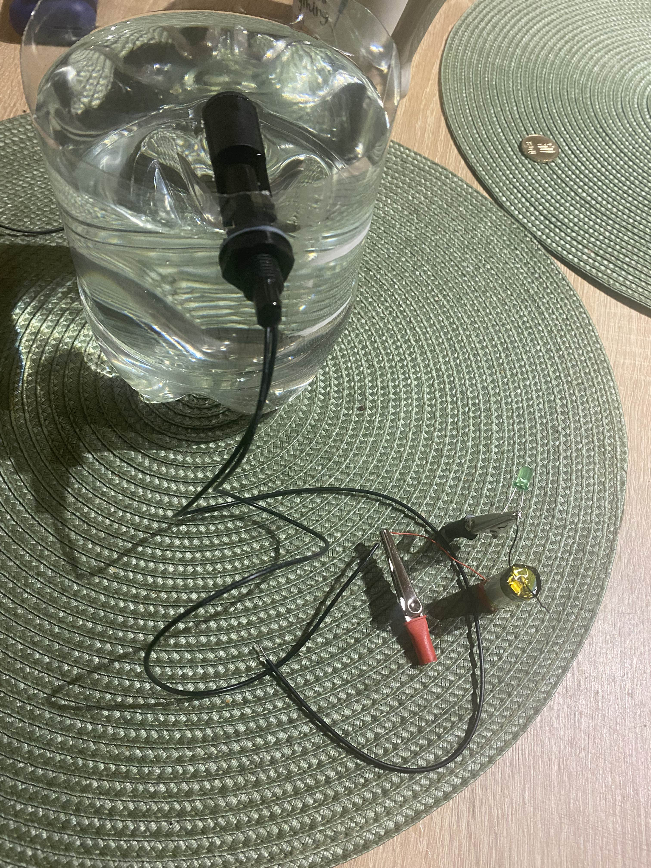
[picture p9: IMG_1314.jpg]
IMG_1314.jpg
