BotyB/Automatic-Plant-Watering-System/IMG_1315.jpg

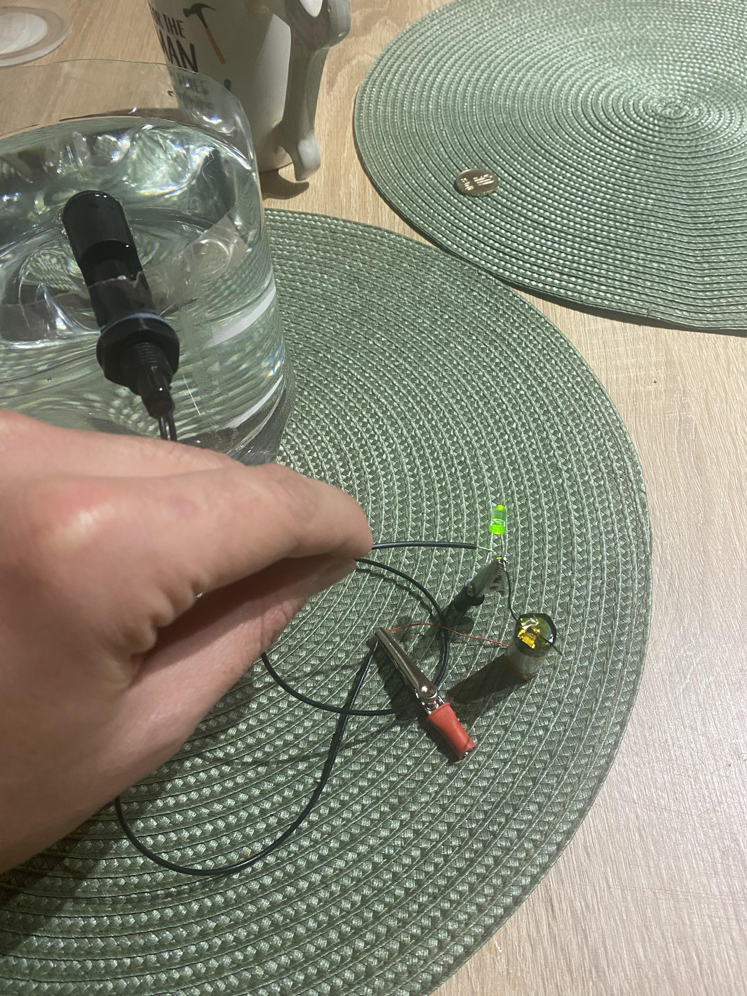
[picture p10: IMG_1315.jpg]
IMG_1315.jpg
