BotyB/Automatic-Plant-Watering-System/IMG_1327.JPG

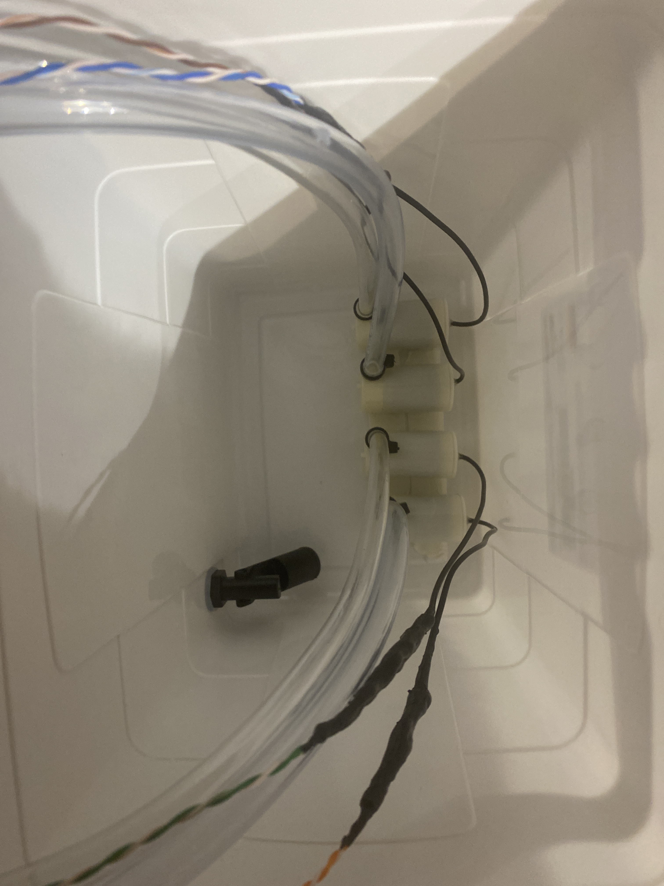
[picture p15: IMG_1327.JPG]
IMG_1327.JPG
