BotyB/Automatic-Plant-Watering-System/IMG_1352.jpg

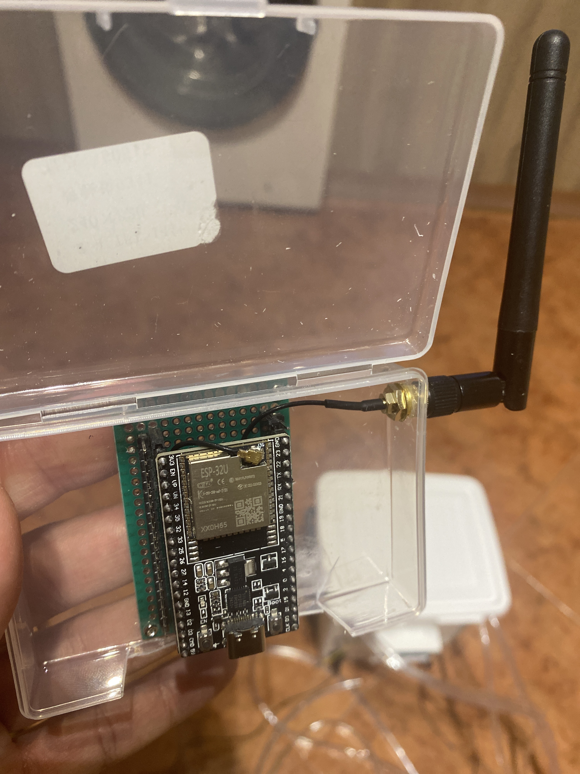
[picture p17: IMG_1352.jpg]
IMG_1352.jpg
