BotyB/Automatic-Plant-Watering-System/IMG_1110.JPG

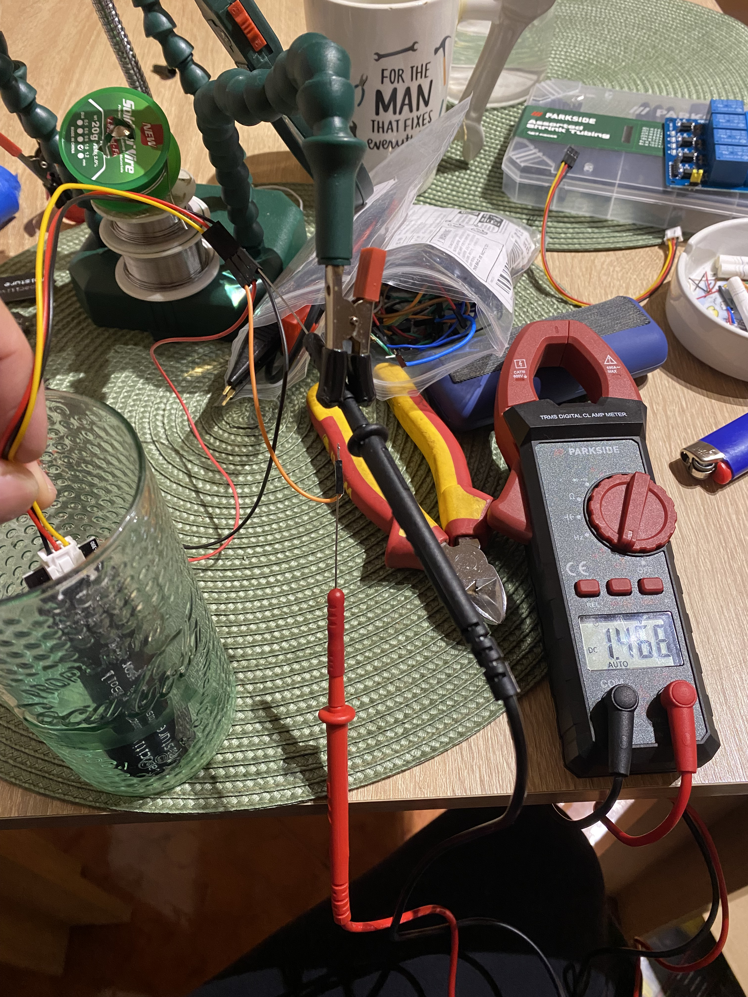
[picture p22: IMG_1110.JPG]
IMG_1110.JPG
