BotyB/Automatic-Plant-Watering-System/IMG_1111.JPG

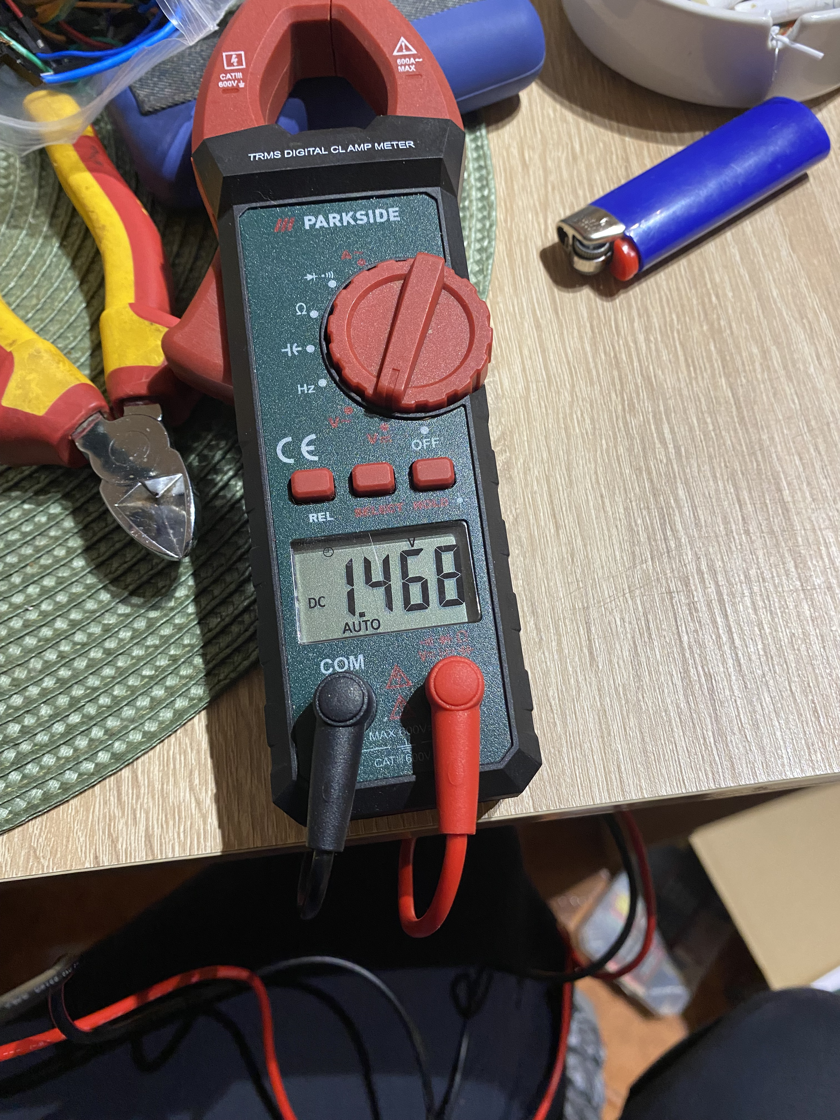
[picture p23: IMG_1111.JPG]
IMG_1111.JPG
