BotyB/Automatic-Plant-Watering-System/IMG_1109.JPG

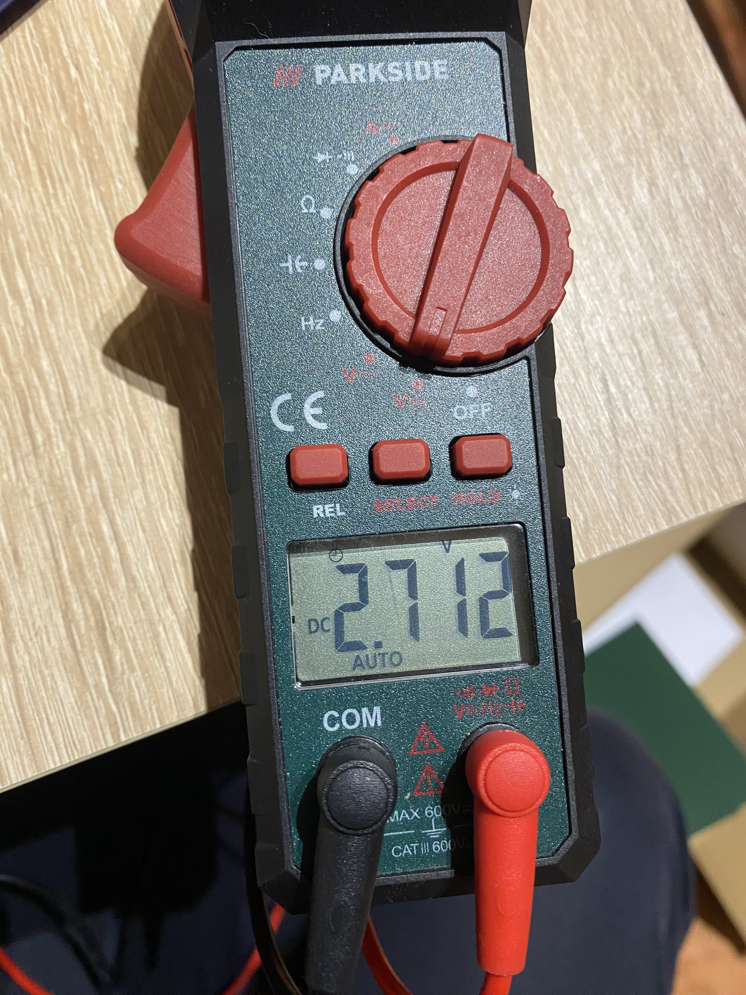
[picture p24: IMG_1109.JPG]
IMG_1109.JPG
